Heavy02011/donkeyhat/schema-plots/20241102-schema-plot.png

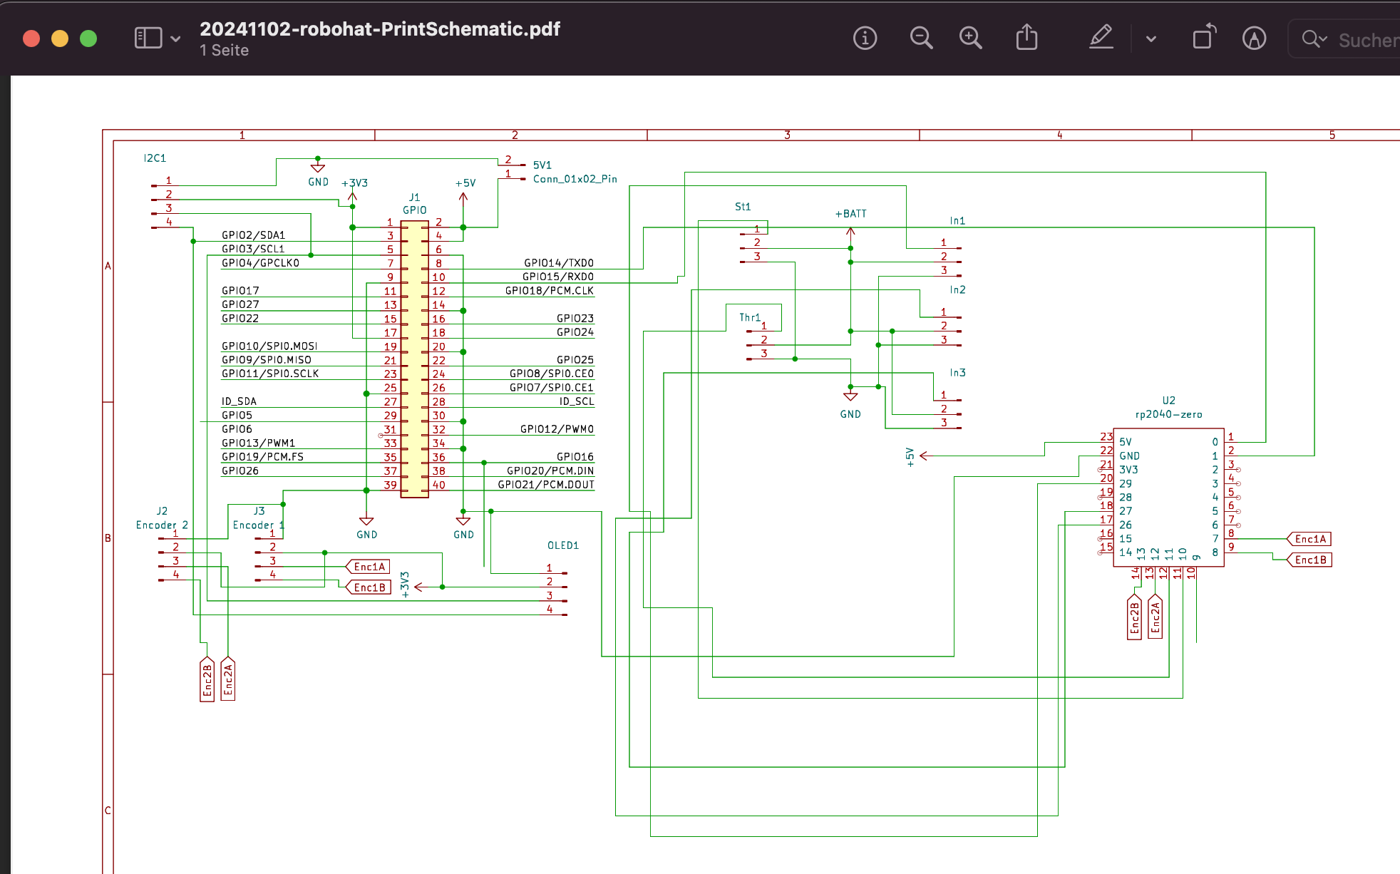
schema-plots/20241102-schema-plot.png
