Heavy02011/donkeyhat/Mini RC hat mount.stl

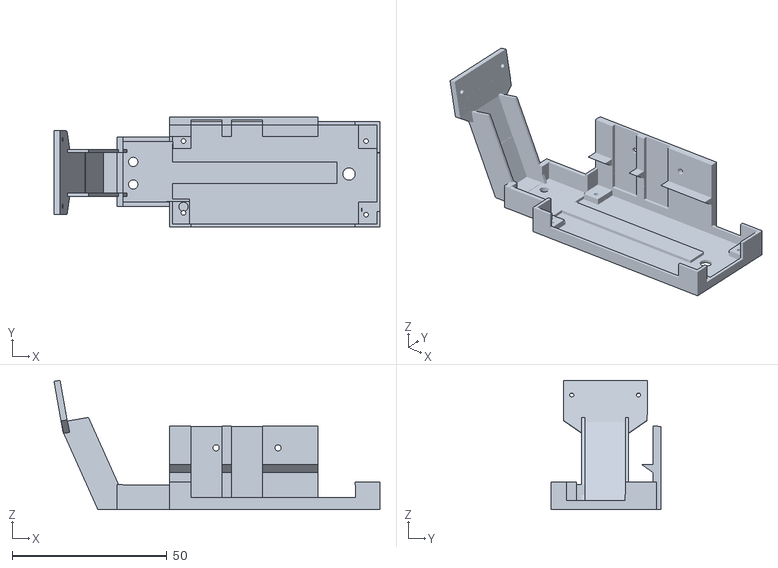
[picture p2: CAD file, 2026-02-08]
Mini RC hat mount.stl
105.4 x 35.5 x 41.8
