Heavy02011/donkeyhat/schema-plots/20241102-robohat-PrintSchematic.pdf

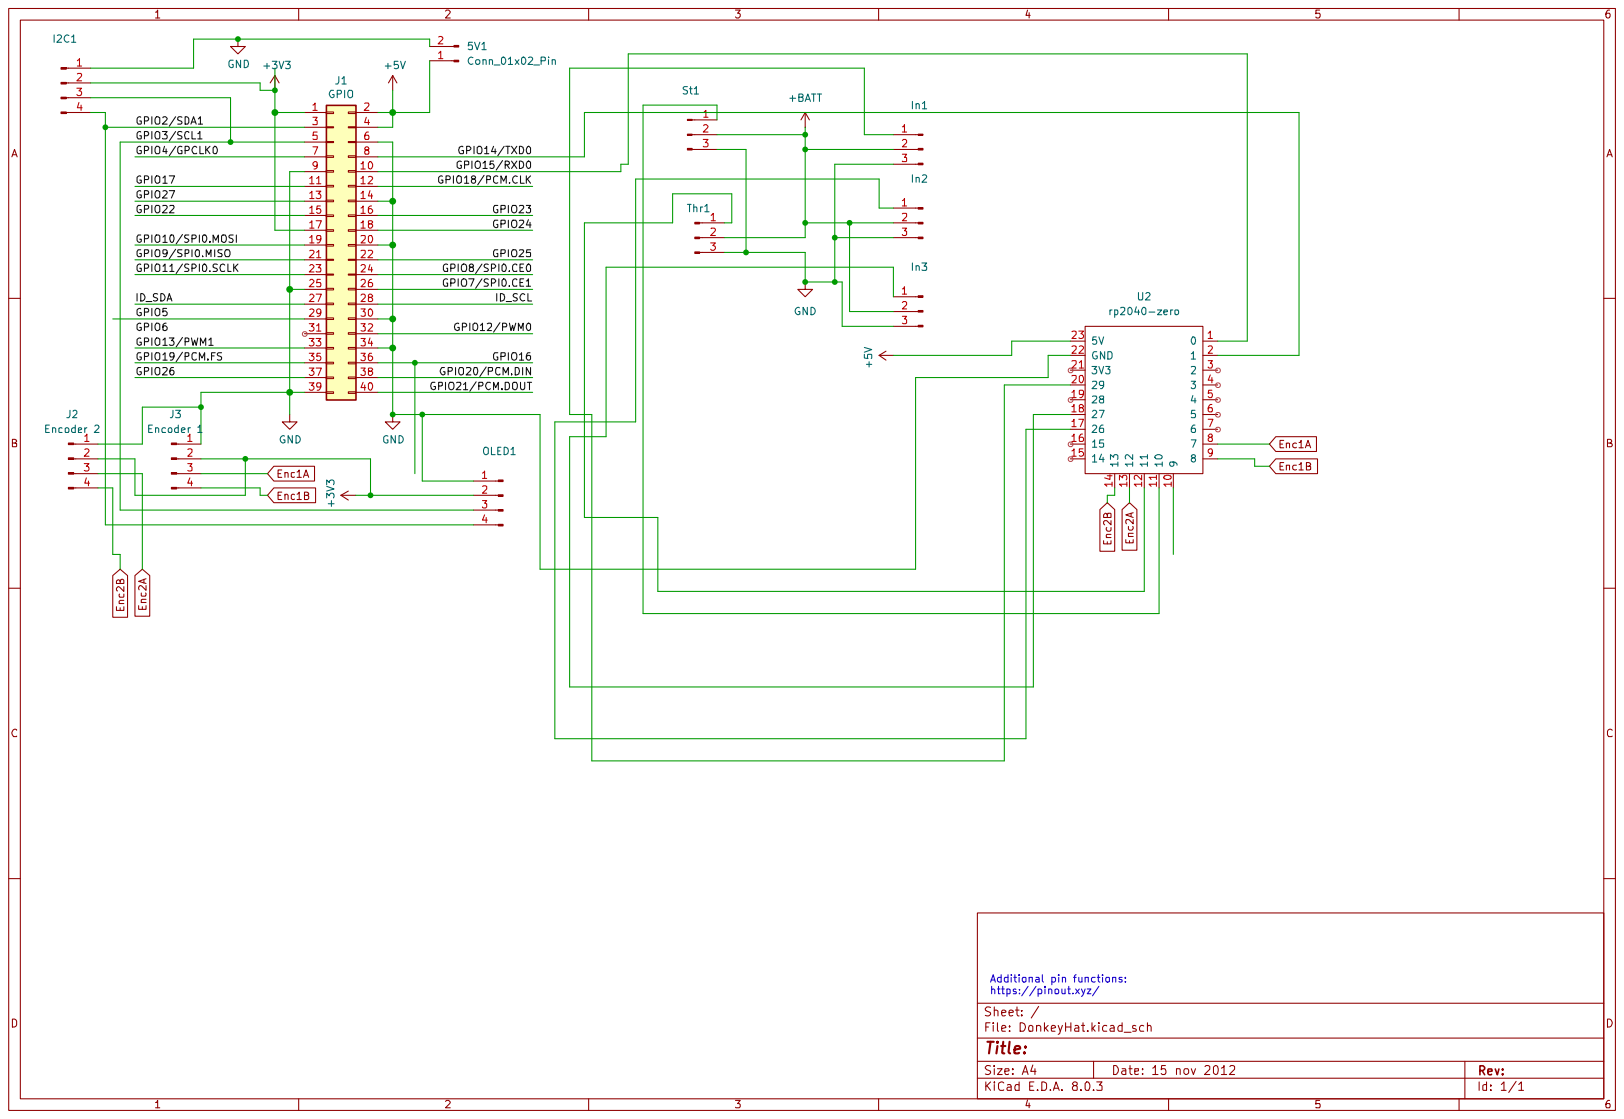
[picture p3: page 1]
