Heavy02011/donkeyhat/DonkeyHat/DonkeyHatZero.kicad_pcb

## KiCad design DonkeyHat/DonkeyHatZero.kicad_pcb (2026-02-08)

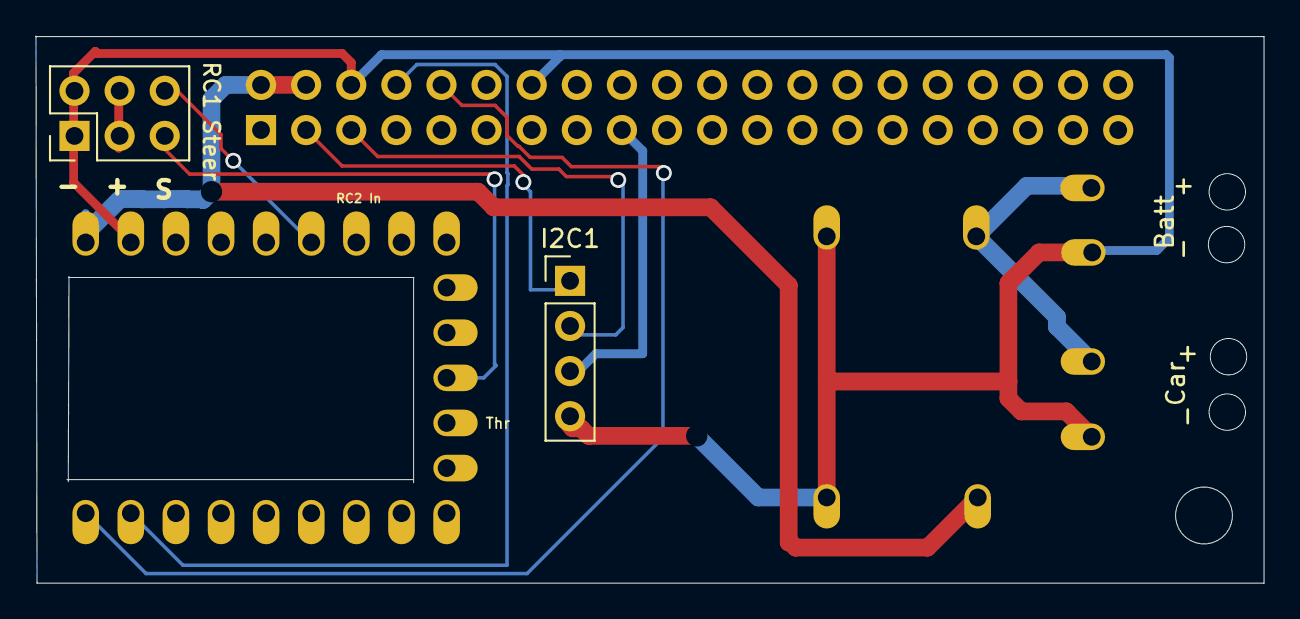
[picture p4: board DonkeyHatZero.kicad_pcb from above]

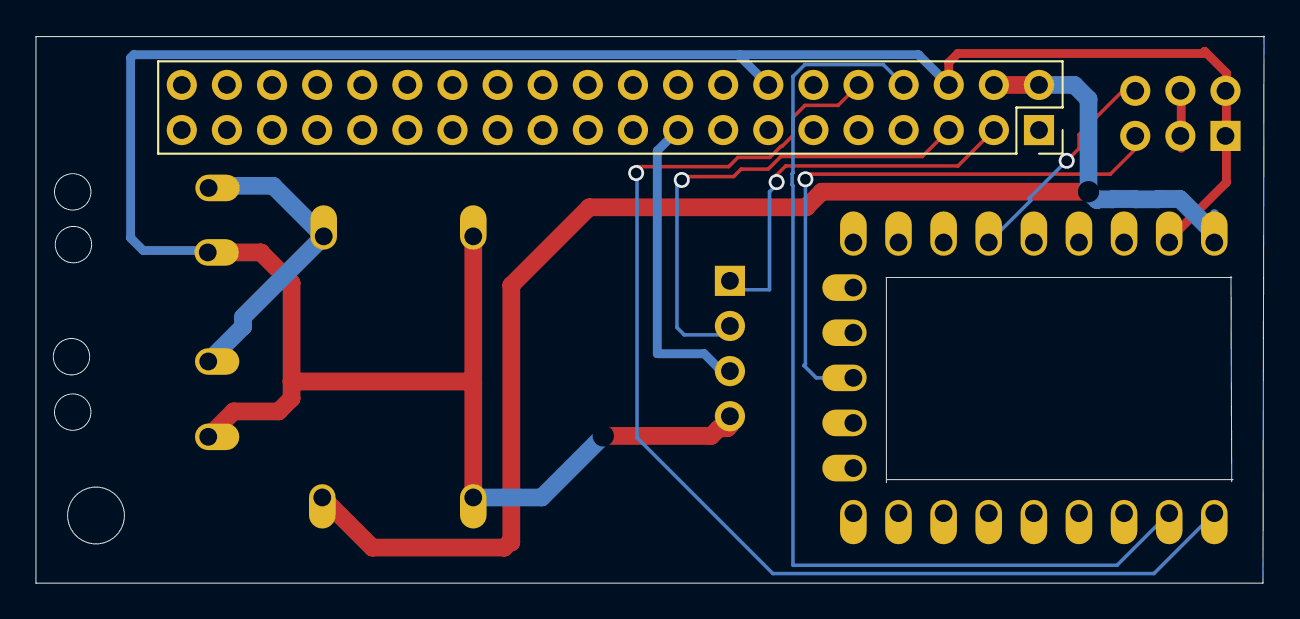
[picture p5: board DonkeyHatZero.kicad_pcb from below]

Board: 2 copper layers, 69.1 x 30.8 mm, 4 parts (2 on the bottom side), 10 nets.

Parts:
I2C1: Conn_01x04_Pin; PinHeader_1x04_P2.54mm_Vertical
J1: GPIO; PinSocket_2x20_P2.54mm_Vertical
J4: Conn_02x03_Top_Bottom; PinHeader_2x03_P2.54mm_Vertical
U2: rp2040-zero; rp2040-zero-tht

Connections:
+3V3: I2C1.3, J1.1, J1.17
+5V: J1.2, J1.4, U2.23 (5V)
/GPIO2/SDA1: I2C1.1, J1.3
/GPIO3/SCL1: I2C1.2, J1.5
GND: I2C1.4, J1.6, J1.14, J4.1, J4.4, U2.22 (GND)
unnamed: J4.2, J4.5
RCin1: J4.6, U2.18 (27)
Rpi Rx: J1.10, U2.1 (0)
Rpi Tx: J1.8, U2.2 (1)
Steer: J4.3, U2.12 (11)
