Heavy02011/donkeyhat/DonkeyHat/DonkeyHat-prod.kicad_pcb

## KiCad design DonkeyHat/DonkeyHat-prod.kicad_pcb (2026-02-08)

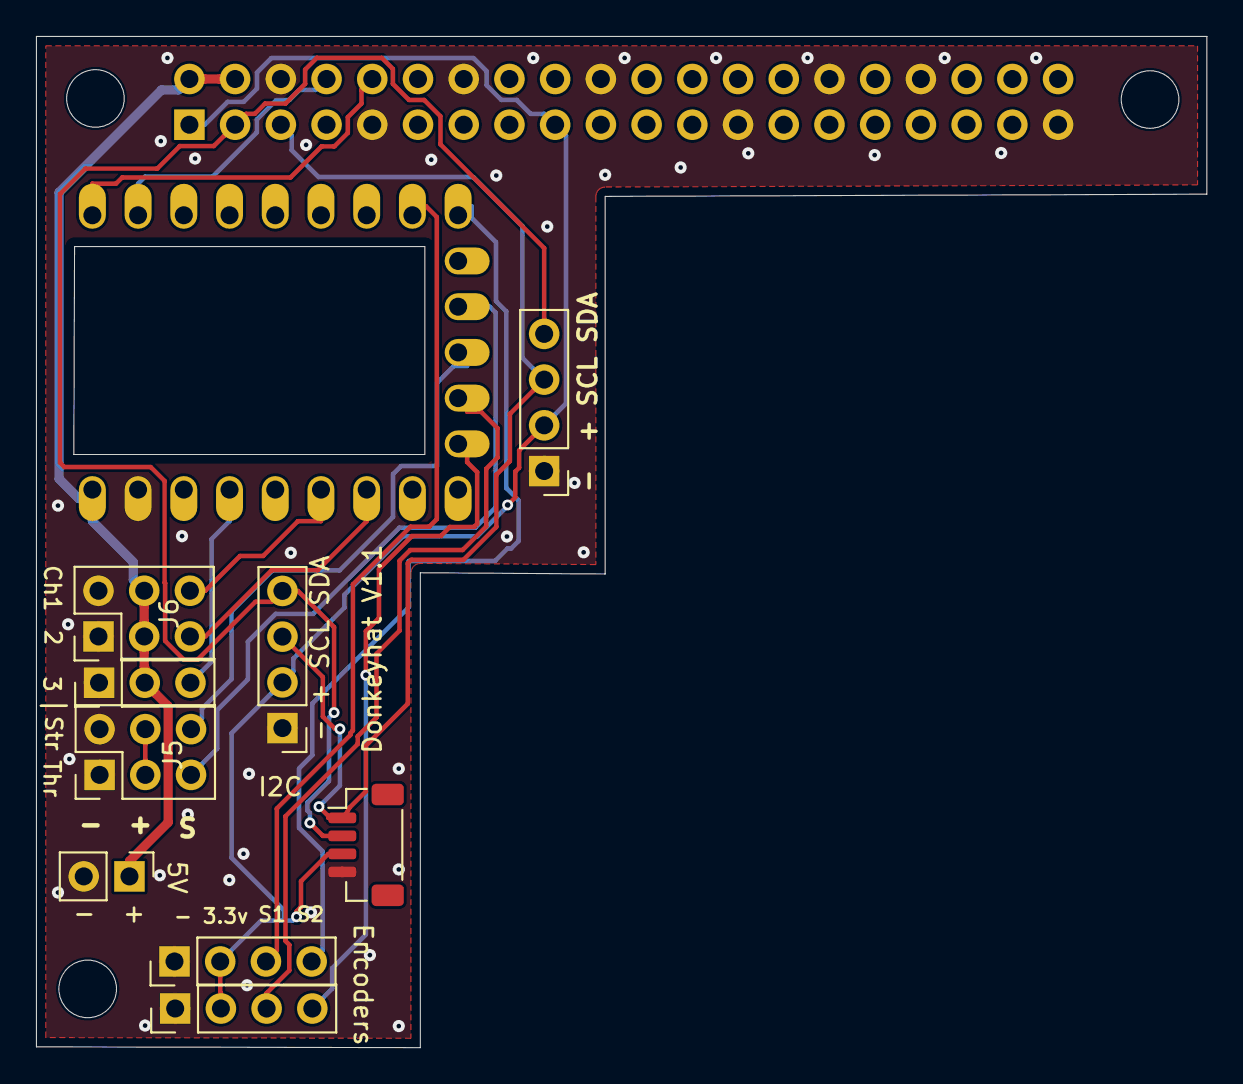
[picture p6: board DonkeyHat-prod.kicad_pcb from above]

Board: 2 copper layers, 65.0 x 56.2 mm, 11 parts (1 on the bottom side), 17 nets.

Parts:
5V1: Conn_01x02_Pin; PinHeader_1x02_P2.54mm_Vertical
I2C1: Conn_01x04_Pin; PinHeader_1x04_P2.54mm_Vertical
J1: GPIO; PinSocket_2x20_P2.54mm_Vertical
J2: Encoder 2; PinHeader_1x04_P2.54mm_Vertical
J3: Encoder 1; PinHeader_1x04_P2.54mm_Vertical
J4: I2C; JST_SH_BM04B-SRSS-TB_1x04-1MP_P1.00mm_Vertical
J5, J6: Conn_02x03_Odd_Even; PinHeader_2x03_P2.54mm_Vertical
OLED1: Conn_01x04_Pin; PinHeader_1x04_P2.54mm_Vertical
Throttle1: Conn_01x03_Pin; PinHeader_1x03_P2.54mm_Vertical
U2: rp2040-zero; rp2040-zero-tht

Connections:
+3V3: I2C1.2, J1.1, J1.17, J2.2, J3.2, J4.3, OLED1.2
+5V: 5V1.1, J1.2, J1.4, J6.3, J6.4, Throttle1.2, U2.23 (5V)
/GPIO2/SDA1: I2C1.4, J1.3, J4.2, OLED1.4
/GPIO3/SCL1: I2C1.3, J1.5, J4.1, OLED1.3
Batt: J5.3, J5.4
Enc1A: J3.3, U2.8 (7)
Enc1B: J3.4, U2.9 (8)
Enc2A: J2.3, U2.13 (12)
Enc2B: J2.4, U2.14 (13)
GND: 5V1.2, I2C1.1, J1.6, J1.9, J1.14, J1.20, J1.25, J1.30, J1.34, J1.39, J2.1, J3.1, J4.4, J5.1, J5.2, J6.1, J6.2, OLED1.1, Throttle1.1, U2.22 (GND)
RCin1: J6.6, U2.18 (27)
RCin2: J6.5, U2.17 (26)
RCin3: Throttle1.3, U2.20 (29)
Rpi Rx: J1.10, U2.1 (0)
Rpi Tx: J1.8, U2.2 (1)
Steer: J5.6, U2.12 (11)
Throttle: J5.5, U2.11 (10)
