Heavy02011/donkeyhat/code.py

# Donkey Car Driver for 2040-based boards such as the Raspberry Pi Pico and KB2040
#
# Notes:
#   This is to be run using CircuitPython 10.x
#   Last Updated: 1/21/2026

import time
import board
import busio
import neopixel
from pulseio import PulseIn
from pwmio import PWMOut
import digitalio
import rotaryio

# Customisation variables
DEBUG = False
USB_SERIAL = False
SMOOTHING_INTERVAL_IN_S = 0.025
ACCEL_RATE = 10
USE_QUADRATURE = False  # Set to False to use regular encoder
ESTOP_THRESHOLD = 1700  # CH3 above this value triggers e-stop


# Pin assignments
RC1 = board.GP27
RC2 = board.GP26
RC3 = board.GP29
Steering = board.GP11
Throttle = board.GP10
Encoder1A_pin = board.GP8
Encoder1B_pin = board.GP9
Encoder2A_pin = board.GP13
Encoder2B_pin = board.GP14

if USE_QUADRATURE:
    # Set up the quadrature encoders
    encoder1 = rotaryio.IncrementalEncoder(Encoder1A_pin, Encoder1B_pin)
    encoder2 = rotaryio.IncrementalEncoder(Encoder2A_pin, Encoder2B_pin)
else:
    # Set up pins for regular encoders
    encoder1 = digitalio.DigitalInOut(Encoder1A_pin)
    encoder1.direction = digitalio.Direction.INPUT
    encoder1.pull = digitalio.Pull.DOWN

    encoder2 = digitalio.DigitalInOut(Encoder2A_pin)
    encoder2.direction = digitalio.Direction.INPUT
    encoder2.pull = digitalio.Pull.DOWN

pixel = neopixel.NeoPixel(board.NEOPIXEL, 1)

## cannot have DEBUG and USB_SERIAL
if USB_SERIAL:
    DEBUG = False

## functions

def servo_duty_cycle(pulse_ms, frequency=60):
    """
    Formula for working out the servo duty_cycle at 16 bit input
    """
    period_ms = 1.0 / frequency * 1000.0
    duty_cycle = int(pulse_ms / 1000 / (period_ms / 65535.0))
    return duty_cycle

def state_changed(control):
    """
    Reads the RC channel and returns smoothed value.
    Uses median filtering for noise rejection and exponential smoothing for responsiveness.
    """
    control.channel.pause()
    valid_values = []
    for i in range(len(control.channel)):
        val = control.channel[i]
        # Only accept values in valid RC range
        if 900 <= val <= 2100:
            valid_values.append(val)

    control.channel.clear()
    control.channel.resume()

    if not valid_values:
        return

    # Use median of valid values to reject outliers/glitches
    valid_values.sort()
    median_val = valid_values[len(valid_values) // 2]

    # Clamp median to valid RC range before smoothing
    median_val = max(1000, min(2000, median_val))

    # Exponential smoothing: 0.7 weight on new value for responsiveness
    control.value = control.value * 0.3 + median_val * 0.7

    # Clamp final value to valid range
    control.value = max(1000, min(2000, control.value))

    # Apply deadband around center
    if 1475 < control.value < 1525:
        control.value = 1500

class Control:
    """
    Class for a RC Control Channel
    """

    def __init__(self, name, servo, channel, value):
        self.name = name
        self.servo = servo
        self.channel = channel
        self.value = value
        if servo is not None:
            self.servo.duty_cycle = servo_duty_cycle(value)

# set up serial UART to Raspberry Pi
uart = busio.UART(board.TX, board.RX, baudrate=115200, timeout=0.001)

# set up servos
steering_pwm = PWMOut(Steering, duty_cycle=2 ** 15, frequency=60)
throttle_pwm = PWMOut(Throttle, duty_cycle=2 ** 15, frequency=60)

# set up RC channels.
steering_channel = PulseIn(RC1, maxlen=64, idle_state=0)
throttle_channel = PulseIn(RC2, maxlen=64, idle_state=0)
mode_channel = PulseIn(RC3, maxlen=64, idle_state=0)

# setup Control objects.  1500 pulse is off and center steering
steering = Control("Steering", steering_pwm, steering_channel, 1500)
throttle = Control("Throttle", throttle_pwm, throttle_channel, 1500)
mode = Control("Mode", None, mode_channel, 1500)  # CH3 for e-stop, no servo output

last_update = time.monotonic()
continuous_mode = False
continuous_delay = 0
estop_active = False

position1 = 0
position2 = 0

def main():
    global last_update, continuous_mode, continuous_delay, position1, position2, estop_active
    last_toggle_time = time.monotonic()
    last_servo_update = time.monotonic()
    interval = 1  # Seconds
    data = bytearray()
    datastr = ''
    last_input = 0
    steering_val = steering.value
    throttle_val = throttle.value
    led_state = False
    color = (0, 0, 255)
    if not USE_QUADRATURE:
        last_state1 = encoder1.value
        last_state2 = encoder2.value

    while True:
        current_time = time.monotonic()
        got_data = False
        if USE_QUADRATURE:
            # Read the positions from the quadrature encoders
            position1 = encoder1.position
            position2 = encoder2.position
        else:
            # Read the positions from the regular encoders
            current_state1 = encoder1.value
            current_state2 = encoder2.value

            if current_state1 != last_state1:  # encoder1 state changed
                if current_state1 == False:  # Detect falling edge
                    position1 += 1

            if current_state2 != last_state2:  # encoder2 state changed
                if current_state2 == False:  # Detect falling edge
                    position2 += 1

            last_state1 = current_state1
            last_state2 = current_state2

        if continuous_mode and (current_time - last_toggle_time >= continuous_delay / 1000.0):
            uart.write(b"%i, %i, %i, %i; %i, %i\r\n" % (
                int(steering.value), int(throttle.value),
                position1, int(current_time * 1000),
                position2, int(current_time * 1000)))
            last_toggle_time = current_time

        if current_time - last_toggle_time >= interval:
            if led_state:
                pixel.fill((0, 0, 0))  # Turn off the NeoPixel
            else:
                pixel.fill(color)  # Set the NeoPixel to the specified color
            pixel.show()
            led_state = not led_state
            last_toggle_time = current_time

        # only update every smoothing interval (to avoid jumping)
        if last_update + SMOOTHING_INTERVAL_IN_S > current_time:
            continue
        last_update = time.monotonic()

        # check for new RC values (channel will contain data)
        if len(throttle.channel) != 0:
            state_changed(throttle)

        if len(steering.channel) != 0:
            state_changed(steering)

        # Check CH3 for e-stop
        if len(mode.channel) != 0:
            state_changed(mode)

        # E-stop: if CH3 is high, force throttle to neutral
        if mode.value > ESTOP_THRESHOLD:
            if not estop_active:
                estop_active = True
                color = (255, 0, 0)  # Red for e-stop
                print("E-STOP ACTIVE")
            throttle.value = 1500
            throttle_val = 1500
        elif estop_active:
            estop_active = False
            color = (0, 0, 255)  # Back to blue
            print("E-STOP RELEASED")

        if USB_SERIAL:
            # simulator USB
            print("%i, %i" % (int(steering.value), int(throttle.value)))
        else:
            # write the RC values to the RPi Serial
            uart.write(b"%i, %i\r\n" % (int(steering.value), int(throttle.value)))
            # print(int(steering.value), int(throttle.value))

        while True:
            # wait for data on the serial port and read 1 byte
            byte = uart.read(1)

            # if no data, break and continue with RC control
            if byte is None:
                break



            # if data is received, check if it is the end of a stream
            if byte == b'\r':
                command = datastr.strip()
                datastr = ''
                handle_command(command)
                data = bytearray()
                break

            data[len(data):len(data)] = byte
            datastr = ''.join([chr(c) for c in data]).strip()

            # if we make it here, there is serial data from the previous step
            if len(datastr) >= 10:
                steering_val = steering.value
                throttle_val = throttle.value
                try:
                    steering_val = int(datastr[:4])
                    throttle_val = int(datastr[-4:])
                except ValueError:
                    None

                data = bytearray()
                datastr = ''
                got_data = True
 #               print("Set: steering=%i, throttle=%i" % (steering_val, throttle_val))
        if got_data:
            print("Serial control")
            # Set the servo for serial data (received)
            # E-stop overrides throttle even in serial mode
            if estop_active:
                throttle_val = 1500
            steering.servo.duty_cycle = servo_duty_cycle(steering_val)
            throttle.servo.duty_cycle = servo_duty_cycle(throttle_val)
            last_input = time.monotonic()
        elif current_time > (last_input + 0.1):  # Timeout to switch back to RC control
            # Update servos more frequently to reduce jitter
            if current_time - last_servo_update >= 0.01:  # 100Hz servo update rate
                print("RC control")
                steering.servo.duty_cycle = servo_duty_cycle(steering.value)
                # E-stop forces throttle to neutral
                if estop_active:
                    throttle.servo.duty_cycle = servo_duty_cycle(1500)
                else:
                    throttle.servo.duty_cycle = servo_duty_cycle(throttle.value)
                last_servo_update = current_time


def handle_command(command):
    global position1, position2, continuous_mode, continuous_delay
    if command == 'r':
        position1 = 0
        position2 = 0
        if USE_QUADRATURE:
            encoder1.position = 0
            encoder2.position = 0
        print("Positions reset to zero")
    elif command == 'p':
        current_time = time.monotonic()
        uart.write(b"%i, %i, %i, %i; %i, %i\r\n" % (
            int(steering.value), int(throttle.value),
            position1, int(current_time * 1000),
            position2, int(current_time * 1000)))
        print("Position sent")
    elif command.startswith('c'):
        if len(command) > 1 and command[1:].isdigit():
            continuous_delay = int(command[1:])
            continuous_mode = True
            print(f"Continuous mode started with {continuous_delay} ms delay")
        else:
            continuous_mode = not continuous_mode
            if continuous_mode:
                print("Continuous mode started with default delay")
            else:
                print("Continuous mode stopped")

# Run
print("Run!")
main()
